Abdelaziz12121/Automated-Shape-Sorting-and-Quality-Control-System/WhatsApp Image 2025-05-12 at 10.37.28_b9d84d89.jpg

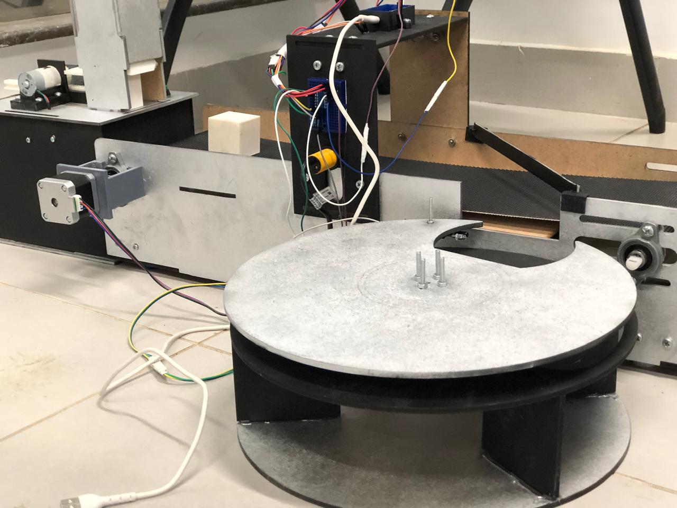
WhatsApp Image 2025-05-12 at 10.37.28_b9d84d89.jpg
