Abdelaziz12121/Automated-Shape-Sorting-and-Quality-Control-System/Screenshot 2025-02-18 090536.png

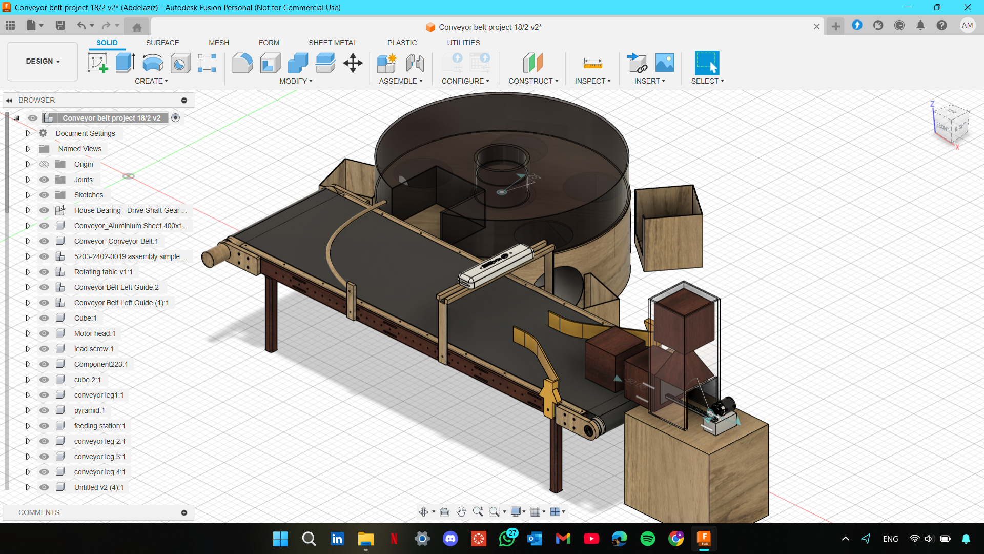
Screenshot 2025-02-18 090536.png
