Abdelaziz12121/Automated-Shape-Sorting-and-Quality-Control-System/Screenshot 2025-02-23 001106.png

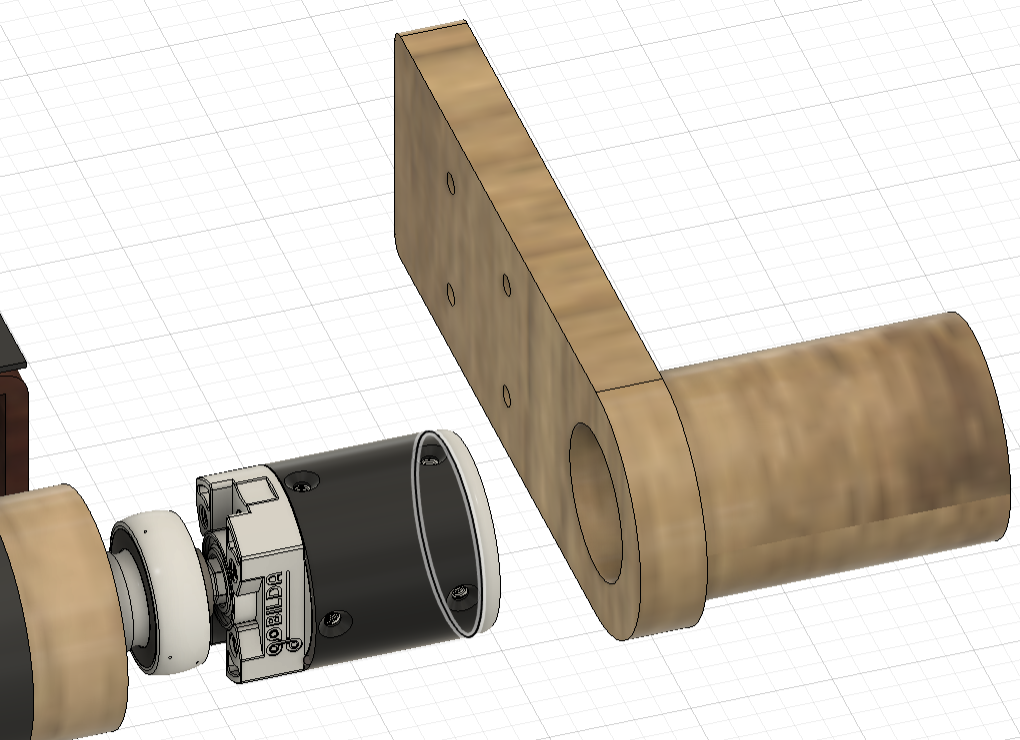
Screenshot 2025-02-23 001106.png
