Abdelaziz12121/Automated-Shape-Sorting-and-Quality-Control-System/Screenshot 2025-02-23 003001.png

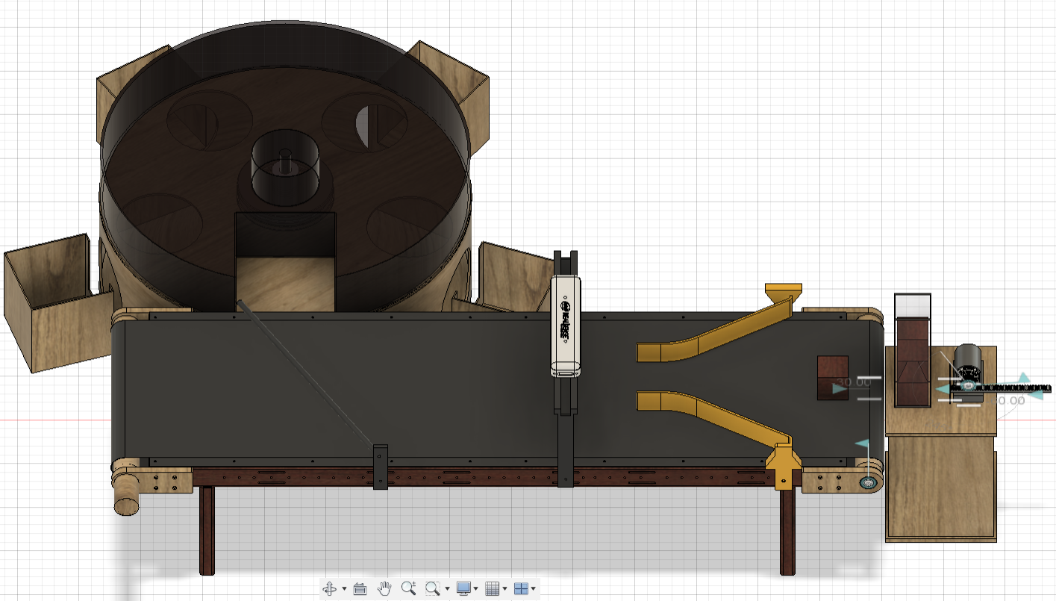
Screenshot 2025-02-23 003001.png
