Abdelaziz12121/Automated-Shape-Sorting-and-Quality-Control-System/Screenshot 2025-03-04 020146.png

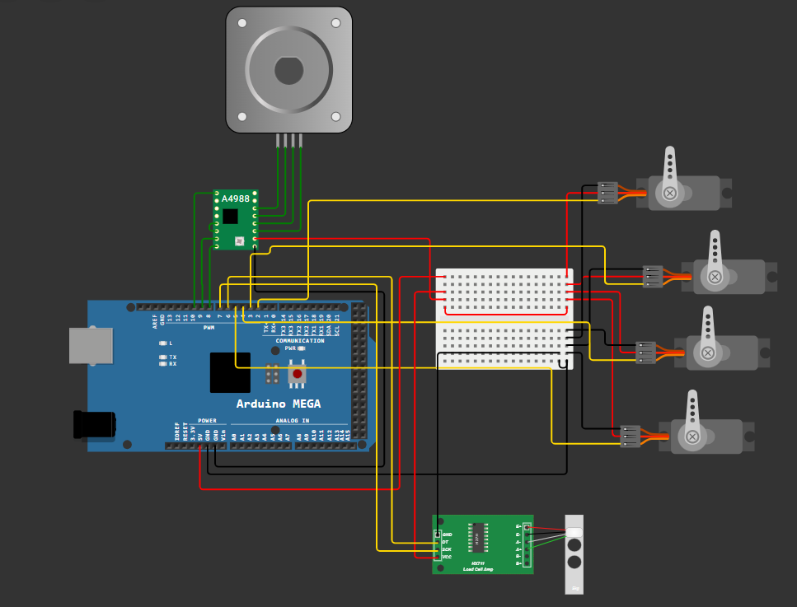
Screenshot 2025-03-04 020146.png
