Abdelaziz12121/Automated-Shape-Sorting-and-Quality-Control-System/Screenshot 2025-03-13 004733.png

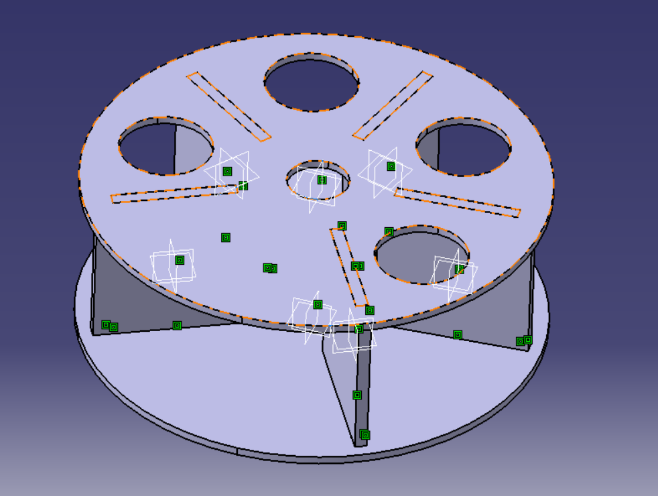
Screenshot 2025-03-13 004733.png
