Abdelaziz12121/Automated-Shape-Sorting-and-Quality-Control-System/Screenshot 2025-03-16 100300.png

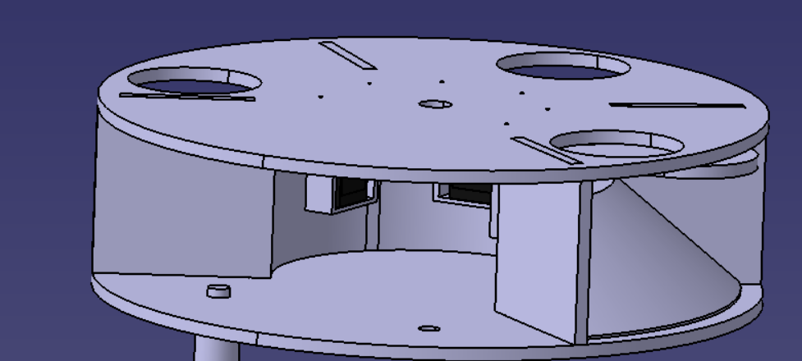
Screenshot 2025-03-16 100300.png
