Abdelaziz12121/Automated-Shape-Sorting-and-Quality-Control-System/Screenshot 2025-05-11 162413.png

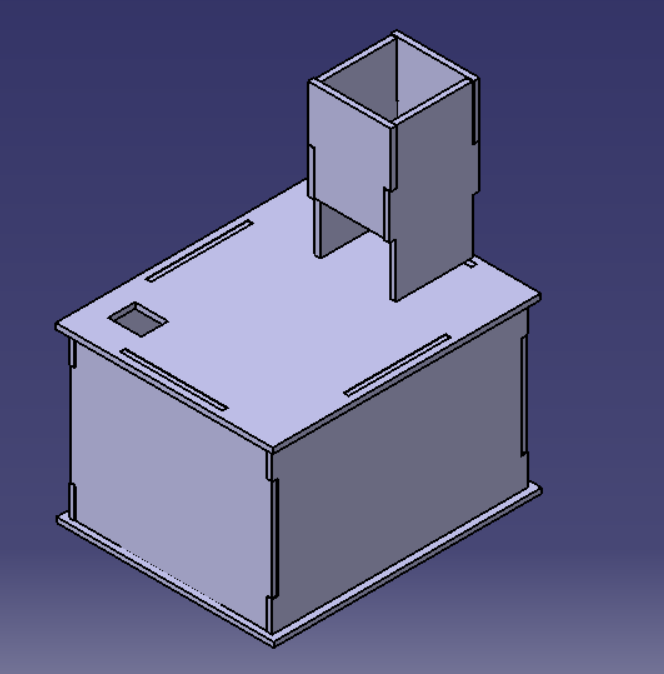
Screenshot 2025-05-11 162413.png
