Abdelaziz12121/Automated-Shape-Sorting-and-Quality-Control-System/Screenshot 2025-05-12 085333.png

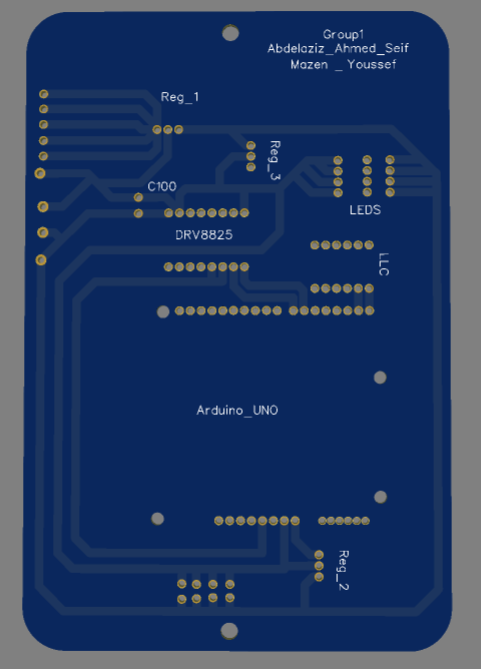
Screenshot 2025-05-12 085333.png
